rmskkn/fanny/hardware/datasheets/README.md

# Datasheets

The PDFs are not stored in the repository. Download them from the manufacturers:

| Part | Source |
|---|---|
| STM32F103C8T6 | https://www.st.com/en/microcontrollers-microprocessors/stm32f103c8.html (datasheet DS5319, reference manual RM0008) |
| BSS138 | https://www.onsemi.com/products/discrete-power-modules/mosfets/bss138 |
| BAT54S | https://www.nexperia.com/products/diodes/schottky-diodes-and-rectifiers |
| SMBJ13A | https://www.littelfuse.com (SMBJ series) |
| AO3401A | https://www.aosmd.com (AO3401A, `Q_hs` high-side P-MOSFET) |
| MMBT3906 | https://www.onsemi.com/products/discrete-power-modules/bipolar-transistors/mmbt3906 (`Q_pnp` level shifter) |
| SS34 | https://www.diodes.com (SS3x Schottky series, fan motor flyback diode) |
| MF-MSMF250/16X / MF-MSMF110/16 | https://www.bourns.com (MF-MSMF series) |
| NTC 10 kΩ B3950 | Probe bundled with the [Skip0ner 1X4L fan-1248 conf v1](https://skiponer.com/1x4l-pwm-fan-controller-manual/) module (AIN NTC; no separate manufacturer PDF, see `hardware/datasheets/NTC-10k-B3950 Response Curve.md`) |
| 4-wire fan spec | Intel "4-Wire Pulse Width Modulation (PWM) Controlled Fans" rev 1.3 |
