rmskkn/fanny/hardware/pcb_top.png

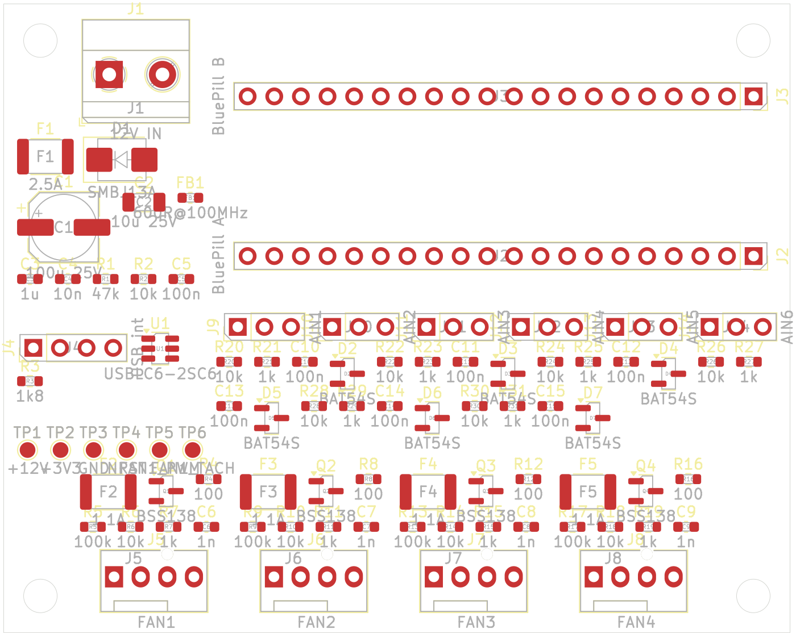
hardware/pcb_top.png
