rmskkn/fanny/hardware/bom.csv

Qty | References | Value | Footprint | MPN (example) | DigiKey PN | DigiKey URL | Notes | DNP
1 | C1 | 100n | C_0603_1608Metric | Yageo CC0603KRX7R9BB104 | 311-1344-2-ND | https://www.digikey.com/en/products/detail/yageo/CC0603KRX7R9BB104/2103082
4 | C2 C3 C4 C5 | 1n | C_0603_1608Metric | Yageo CC0603KRX7R9BB102 | 311-1080-2-ND | https://www.digikey.com/en/products/detail/yageo/CC0603KRX7R9BB102/302814
1 | D1 | SMBJ13A | D_SMB | Littelfuse SMBJ13A | SMBJ13ALFTR-ND | https://www.digikey.com/en/products/detail/littelfuse-inc/SMBJ13A/285974
4 | D2 D3 D4 D5 | SS34 | D_SMA | SMC Diode Solutions SS34AF | 1655-SS34AFTR-ND | https://www.digikey.com/en/products/detail/smc-diode-solutions/SS34AF/21705400
4 | D6 D7 D8 D9 | BAT54S | SOT-23 | Nexperia BAT54S,215 | 1727-2904-2-ND | https://www.digikey.com/en/products/detail/nexperia-usa-inc/BAT54S-215/763218
1 | F1 | 2.5A | Fuse_1812_4532Metric | Bourns MF-MSMF250/16X-2 | MF-MSMF250/16X-2TR-ND | https://www.digikey.com/en/products/detail/bourns-inc/MF-MSMF250-16X-2/2563289
4 | F2 F3 F4 F5 | 1.1A | Fuse_1812_4532Metric | Bourns MF-MSMF110/16-2 | MF-MSMF110/16-2TR-ND | https://www.digikey.com/en/products/detail/bourns-inc/MF-MSMF110-16-2/662820 | Bourns marks this Not For New Designs (in stock, fine for prototype)
1 | J1 | 12V IN | ConnHeader_MateNLok_1x04_P5.08mm_Vertical | On-Shore Technology OSTOQ045450 | ED2845-ND | https://www.digikey.com/en/products/detail/on-shore-technology-inc/OSTOQ045450/1588257
1 | J2 | BluePill A | PinSocket_1x20_P2.54mm_Vertical | Sullins PPTC201LFBN-RC | S7018-ND | https://www.digikey.com/en/products/detail/sullins-connector-solutions/PPTC201LFBN-RC/810158
1 | J3 | BluePill B | PinSocket_1x20_P2.54mm_Vertical | Sullins PPTC201LFBN-RC | S7018-ND | https://www.digikey.com/en/products/detail/sullins-connector-solutions/PPTC201LFBN-RC/810158
1 | J4 | FAN1 | FanPinHeader_1x04_P2.54mm_Vertical | Molex 47053-1000 | WM4330-ND | https://www.digikey.com/en/products/detail/molex/0470531000/2421261
1 | J5 | FAN2 | FanPinHeader_1x04_P2.54mm_Vertical | Molex 47053-1000 | WM4330-ND | https://www.digikey.com/en/products/detail/molex/0470531000/2421261
1 | J6 | FAN3 | FanPinHeader_1x04_P2.54mm_Vertical | Molex 47053-1000 | WM4330-ND | https://www.digikey.com/en/products/detail/molex/0470531000/2421261
1 | J7 | FAN4 | FanPinHeader_1x04_P2.54mm_Vertical | Molex 47053-1000 | WM4330-ND | https://www.digikey.com/en/products/detail/molex/0470531000/2421261
1 | J8 | AIN3 | PinHeader_1x03_P2.54mm_Vertical | Sullins PRPC003SAAN-RC | 35-PRPC003SAAN-RC-ND | https://www.digikey.com/en/products/detail/sullins-connector-solutions/PRPC003SAAN-RC/2775251
1 | J9 | AIN4 | PinHeader_1x03_P2.54mm_Vertical | Sullins PRPC003SAAN-RC | 35-PRPC003SAAN-RC-ND | https://www.digikey.com/en/products/detail/sullins-connector-solutions/PRPC003SAAN-RC/2775251
1 | J10 | AIN1 | PinHeader_1x03_P2.54mm_Vertical | Sullins PRPC003SAAN-RC | 35-PRPC003SAAN-RC-ND | https://www.digikey.com/en/products/detail/sullins-connector-solutions/PRPC003SAAN-RC/2775251
1 | J11 | AIN2 | PinHeader_1x03_P2.54mm_Vertical | Sullins PRPC003SAAN-RC | 35-PRPC003SAAN-RC-ND | https://www.digikey.com/en/products/detail/sullins-connector-solutions/PRPC003SAAN-RC/2775251
8 | Q1 Q2 Q5 Q6 Q11 Q12 Q17 Q18 | AO3401A | SOT-23 | Alpha & Omega AO3401A | 785-1001-2-ND | https://www.digikey.com/en/products/detail/alpha-omega-semiconductor-inc/AO3401A/1855773 | Not MMBT3906 - that part is no longer used
12 | Q3 Q4 Q7 Q8 Q9 Q10 Q13 Q14 Q15 Q16 Q19 Q20 | BSS138 | SOT-23 | MCC BSS138-TP | BSS138-TPMSTR-ND | https://www.digikey.com/en/products/detail/mcc-micro-commercial-components/BSS138-TP/10054628
13 | R1 R6 R7 R8 R14 R15 R19 R23 R24 R28 R32 R35 R37 | 10k | R_0603_1608Metric | Vishay Dale CRCW060310K0FKEA | 541-10.0KHTR-ND | https://www.digikey.com/en/products/detail/vishay-dale/CRCW060310K0FKEA/1174782
1 | R2 | 3.3k | R_0603_1608Metric | Vishay Dale CRCW06033K30FKEA | 541-3.30KHTR-ND | https://www.digikey.com/en/products/detail/vishay-dale/CRCW06033K30FKEA/1174725
4 | R3 R12 R21 R38 | 4.7k | R_0603_1608Metric | Yageo RC0603FR-074K7L | 311-4.70KHRTR-ND | https://www.digikey.com/en/products/detail/yageo/RC0603FR-074K7L/727212
8 | R4 R10 R13 R17 R25 R26 R31 R33 | 100 | R_0603_1608Metric | Vishay Dale CRCW0603100RFKEA | 541-100HTR-ND | https://www.digikey.com/en/products/detail/vishay-dale/CRCW0603100RFKEA/1174554
4 | R5 R16 R22 R30 | 2.2k | R_0603_1608Metric | Yageo RC0603FR-072K2L | 311-2.20KHRTR-ND | https://www.digikey.com/en/products/detail/yageo/RC0603FR-072K2L/727016
8 | R9 R20 R29 R36 R43 R44 R45 R46 | 1k | R_0603_1608Metric | Vishay Dale CRCW06031K00FKEA | 541-1.00KHTR-ND | https://www.digikey.com/en/products/detail/vishay-dale/CRCW06031K00FKEA/1174668
4 | R11 R18 R27 R34 | 100k | R_0603_1608Metric | Vishay Dale CRCW0603100KFKEA | 541-100KHTR-ND | https://www.digikey.com/en/products/detail/vishay-dale/CRCW0603100KFKEA/1174896
4 | R39 R40 R41 R42 | 33k | R_0603_1608Metric | Vishay Dale CRCW060333K0FKEA | 541-33.0KHTR-ND | https://www.digikey.com/en/products/detail/vishay-dale/CRCW060333K0FKEA/1174839
