rmskkn/fanny/hardware/kicad/fan_controller.step

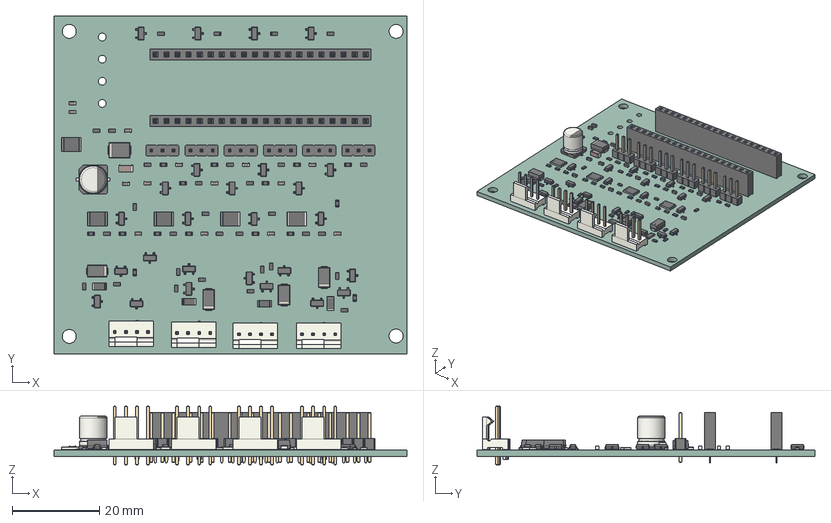
[picture p3: CAD file, 2026-10-23]
hardware/kicad/fan_controller.step
81.0 x 77.5 x 13.5 mm
R_0603_1608Metric x 46
C_0603_1608Metric x 13
R_1206_3216Metric x 4
R_1812_4532Metric x 5
SOT-23 x 16
CP_Elec_63x77
PinHeader_1x03_P254mm_Vertical x 6
SOT_23 x 10
PinSocket_1x20_P2.54mm_Vertical x 2
Fan_Pin_Header_Straight_1x04 x 4
D_SMA x 4
L_0603_1608Metric
C_1206_3216Metric
D_SMB
fan_controller_PCB
