rmskkn/fanny/hardware/kicad/fan_controller.kicad_pcb

## KiCad design hardware/kicad/fan_controller.kicad_pcb (2026-11-14)

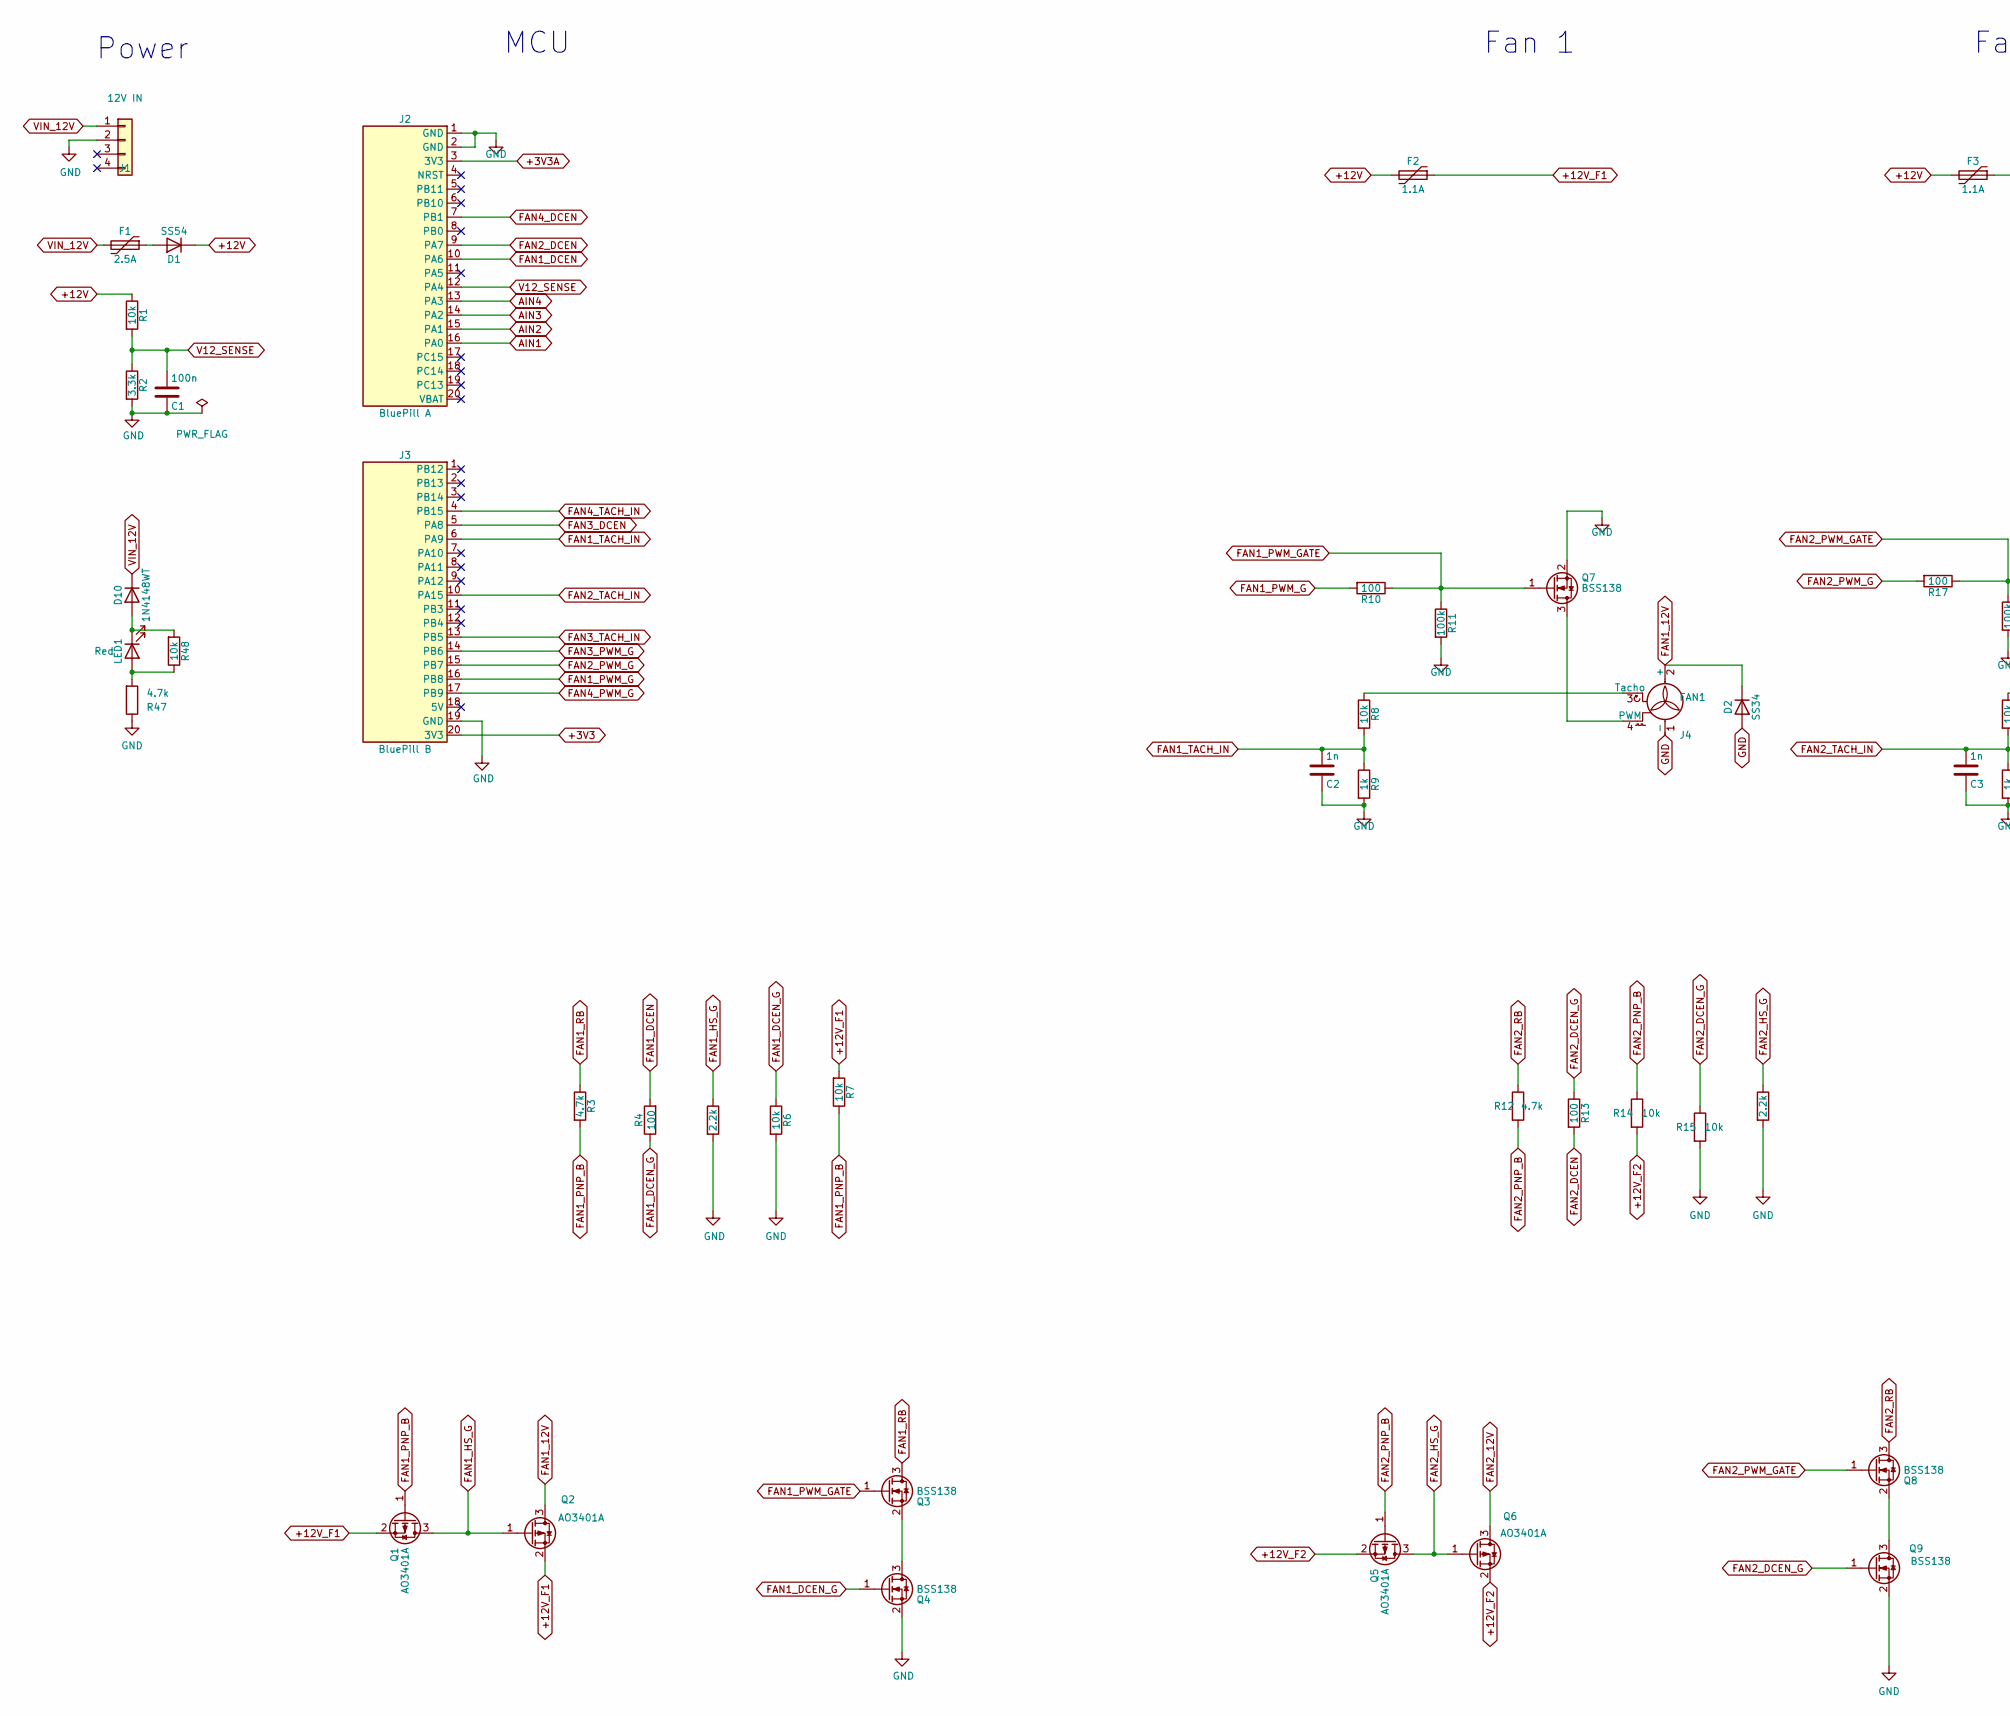
[picture p4: schematic fan_controller.kicad_sch, Fanny - versatile USB PWM fan controller, part in row 1, column 1]

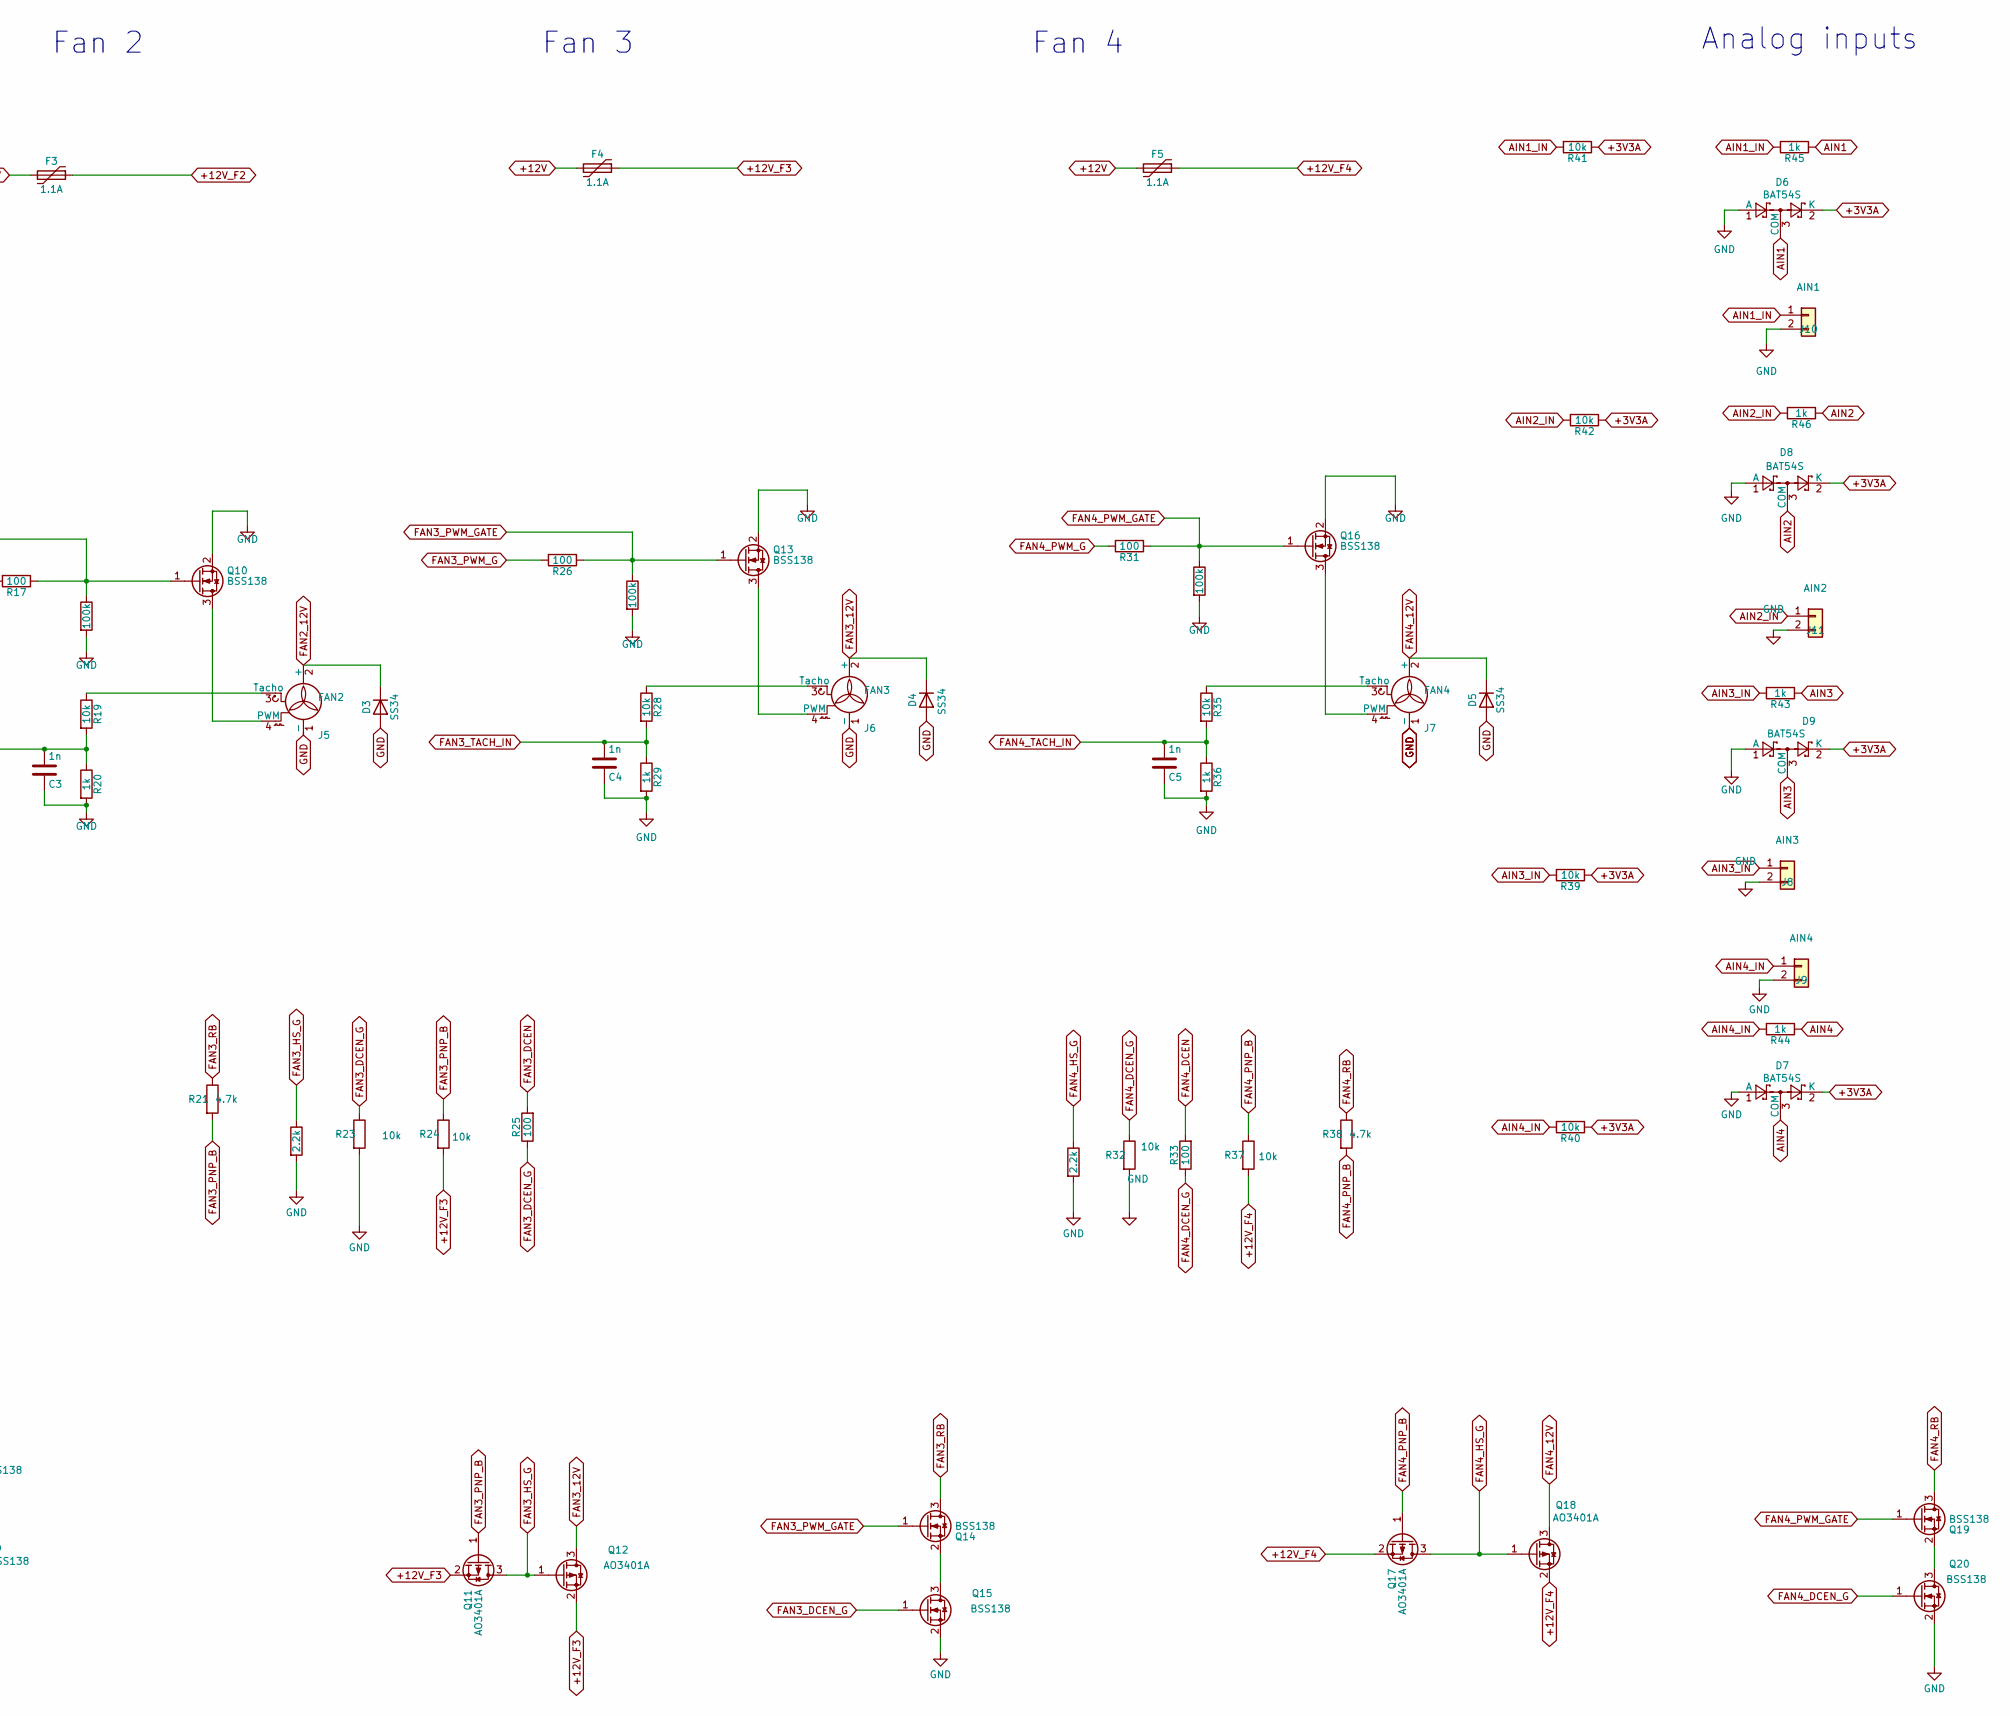
[picture p5: schematic fan_controller.kicad_sch, Fanny - versatile USB PWM fan controller, part in row 1, column 2]

Parts:
C1: 100n; C_0603_1608Metric
C2, C3, C4, C5: 1n; C_0603_1608Metric
D1: SS54; D_SMB; MPN Littelfuse SMBJ13A
D2, D3, D4, D5: SS34; D_SMA; MPN SS34
D6, D7, D8, D9: BAT54S; SOT-23; MPN Nexperia BAT54S,215
D10: 1N4148WT; D_SOD-523
F1: 2.5A; Fuse_1812_4532Metric; MPN Bourns MF-MSMF250/16X-2
F2, F3, F4, F5: 1.1A; Fuse_1812_4532Metric; MPN Bourns MF-MSMF110/16-2
J1: 12V IN; ConnHeader_MateNLok_1x04_P5.08mm_Vertical; MPN TE Connectivity 350424-1
J2: BluePill A; PinSocket_1x20_P2.54mm_Vertical
J3: BluePill B; PinSocket_1x20_P2.54mm_Vertical
J4: FAN1; FanPinHeader_1x04_P2.54mm_Vertical; MPN Molex 47053-1000
J5: FAN2; FanPinHeader_1x04_P2.54mm_Vertical; MPN Molex 47053-1000
J6: FAN3; FanPinHeader_1x04_P2.54mm_Vertical; MPN Molex 47053-1000
J7: FAN4; FanPinHeader_1x04_P2.54mm_Vertical; MPN Molex 47053-1000
J8: AIN3; JST_PH_B2B-PH-K_1x02_P2.00mm_Vertical
J9: AIN4; JST_PH_B2B-PH-K_1x02_P2.00mm_Vertical
J10: AIN1; JST_PH_B2B-PH-K_1x02_P2.00mm_Vertical
J11: AIN2; JST_PH_B2B-PH-K_1x02_P2.00mm_Vertical
LED1: Red; LED_0603_1608Metric
Q1, Q2, Q5, Q6, Q11, Q12, Q17, Q18: AO3401A; SOT-23; MPN Alpha & Omega AO3401A
Q3, Q7, Q8, Q10, Q13, Q14, Q16, Q19: BSS138; SOT-23; MPN onsemi BSS138
Q4, Q9, Q15, Q20: BSS138; SOT-23
R1, R6, R7, R8, R14, R15, R19, R23, R24, R28, R32, R35, R37, R39, R40, R41, R42, R48: 10k; R_0603_1608Metric
R2: 3.3k; R_0603_1608Metric
R3, R12, R21, R38: 4.7k; R_0603_1608Metric
R4, R10, R13, R17, R25, R26, R31, R33: 100; R_0603_1608Metric
R5, R16, R22, R30: 2.2k; R_0603_1608Metric
R9, R20, R29, R36, R43, R44, R45, R46: 1k; R_0603_1608Metric
R11, R18, R27, R34: 100k; R_0603_1608Metric
R47: 4.7k; R_1206_3216Metric

Connections:
+3V3: J3.20 (3V3); also elsewhere on the board
+3V3A: D6.2 (K), D7.2 (K), D8.2 (K), D9.2 (K), J2.3 (3V3), R39.1, R40.1, R41.1, R42.1; also elsewhere on the board
+12V: D1.1 (K), F2.2, F3.2, F4.2, F5.2, R1.1
+12V_F1: F2.1, Q1.2 (S), Q2.2 (S), R7.2
+12V_F2: F3.1, Q5.2 (S), Q6.2 (S), R14.2
+12V_F3: F4.1, Q11.2 (S), Q12.2 (S), R24.2
+12V_F4: F5.1, Q17.2 (S), Q18.2 (S), R37.2
AIN1: D6.3 (COM), J2.16 (PA0), R45.1
AIN1_IN: J10.1, R41.2, R45.2
AIN2: D8.3 (COM), J2.15 (PA1), R46.1
AIN2_IN: J11.1, R42.2, R46.2
AIN3: D9.3 (COM), J2.14 (PA2), R43.1
AIN3_IN: J8.1, R39.2, R43.2
AIN4: D7.3 (COM), J2.13 (PA3), R44.1
AIN4_IN: J9.1, R40.2, R44.2
FAN1_12V: D2.1 (K), J4.2 (+), Q2.3 (D)
FAN1_DCEN: J2.10 (PA6), R4.2
FAN1_DCEN_G: Q4.1 (G), R4.1, R6.1
FAN1_HS_G: Q1.3 (D), Q2.1 (G), R5.1
FAN1_PNP_B: Q1.1 (G), R3.2, R7.1
FAN1_PWM_G: J3.16 (PB8), R10.2
FAN1_PWM_GATE: Q3.1 (G), Q7.1 (G), R10.1, R11.1
FAN1_RB: Q3.3 (D), R3.1
FAN1_TACH_IN: C2.1, J3.6 (PA9), R8.2, R9.1; also elsewhere on the board
FAN2_12V: D3.1 (K), J5.2 (+), Q6.3 (D)
FAN2_DCEN: J2.9 (PA7), R13.2
FAN2_DCEN_G: Q9.1 (G), R13.1, R15.1
FAN2_HS_G: Q5.3 (D), Q6.1 (G), R16.1
FAN2_PNP_B: Q5.1 (G), R12.2, R14.1
FAN2_PWM_G: J3.15 (PB7), R17.2
FAN2_PWM_GATE: Q8.1 (G), Q10.1 (G), R17.1, R18.1
FAN2_RB: Q8.3 (D), R12.1
FAN2_TACH_IN: C3.1, J3.10 (PA15), R19.2, R20.1; also elsewhere on the board
FAN3_12V: D4.1 (K), J6.2 (+), Q12.3 (D)
FAN3_DCEN: J3.5 (PA8), R25.2
FAN3_DCEN_G: Q15.1 (G), R23.1, R25.1
FAN3_HS_G: Q11.3 (D), Q12.1 (G), R22.1
FAN3_PNP_B: Q11.1 (G), R21.2, R24.1
FAN3_PWM_G: J3.14 (PB6), R26.2
FAN3_PWM_GATE: Q13.1 (G), Q14.1 (G), R26.1, R27.1
FAN3_RB: Q14.3 (D), R21.1
FAN3_TACH_IN: C4.1, J3.13 (PB5), R28.2, R29.1; also elsewhere on the board
FAN4_12V: D5.1 (K), J7.2 (+), Q18.3 (D)
FAN4_DCEN: J2.7 (PB1), R33.2
FAN4_DCEN_G: Q20.1 (G), R32.1, R33.1
FAN4_HS_G: Q17.3 (D), Q18.1 (G), R30.1
FAN4_PNP_B: Q17.1 (G), R37.1, R38.2
FAN4_PWM_G: J3.17 (PB9), R31.2
FAN4_PWM_GATE: Q16.1 (G), Q19.1 (G), R31.1, R34.1
FAN4_RB: Q19.3 (D), R38.1
FAN4_TACH_IN: C5.1, J3.4 (PB15), R35.2, R36.1; also elsewhere on the board
GND: C1.2, C2.2, C3.2, C4.2, C5.2, D2.2 (A), D3.2 (A), D4.2 (A), D5.2 (A), D6.1 (A), D7.1 (A), D8.1 (A), D9.1 (A), J1.2, J2.1 (GND), J2.2 (GND), J3.19 (GND), J4.1 (-), J5.1 (-), J6.1 (-), J7.1 (-), J8.2, J9.2, J10.2, J11.2, Q4.2 (S), Q7.2 (S), Q9.2 (S), Q10.2 (S), Q13.2 (S), Q15.2 (S), Q16.2 (S), Q20.2 (S), R2.2, R5.2, R6.2, R9.2, R11.2, R15.2, R16.2, R18.2, R20.2, R22.2, R23.2, R27.2, R29.2, R30.2, R32.2, R34.2, R36.2, R47.1; also elsewhere on the board
unnamed: D1.2 (A), F1.1
unnamed: D10.2 (A), LED1.1 (K), R48.2
unnamed: J4.4 (PWM), Q7.3 (D)
unnamed: J4.3 (Tacho), R8.1
unnamed: J5.4 (PWM), Q10.3 (D)
unnamed: J5.3 (Tacho), R19.1
unnamed: J6.4 (PWM), Q13.3 (D)
unnamed: J6.3 (Tacho), R28.1
unnamed: J7.4 (PWM), Q16.3 (D)
unnamed: J7.3 (Tacho), R35.1
unnamed: LED1.2 (A), R47.2, R48.1
unnamed: Q3.2 (S), Q4.3 (D)
unnamed: Q8.2 (S), Q9.3 (D)
unnamed: Q14.2 (S), Q15.3 (D)
unnamed: Q19.2 (S), Q20.3 (D)
V12_SENSE: C1.1, J2.12 (PA4), R1.2, R2.1
VIN_12V: D10.1 (K), F1.2, J1.1

Notes on the sheet:
Analog inputs
Power
Fan 3
MCU
Fan 2
Fan 1
Fan 4

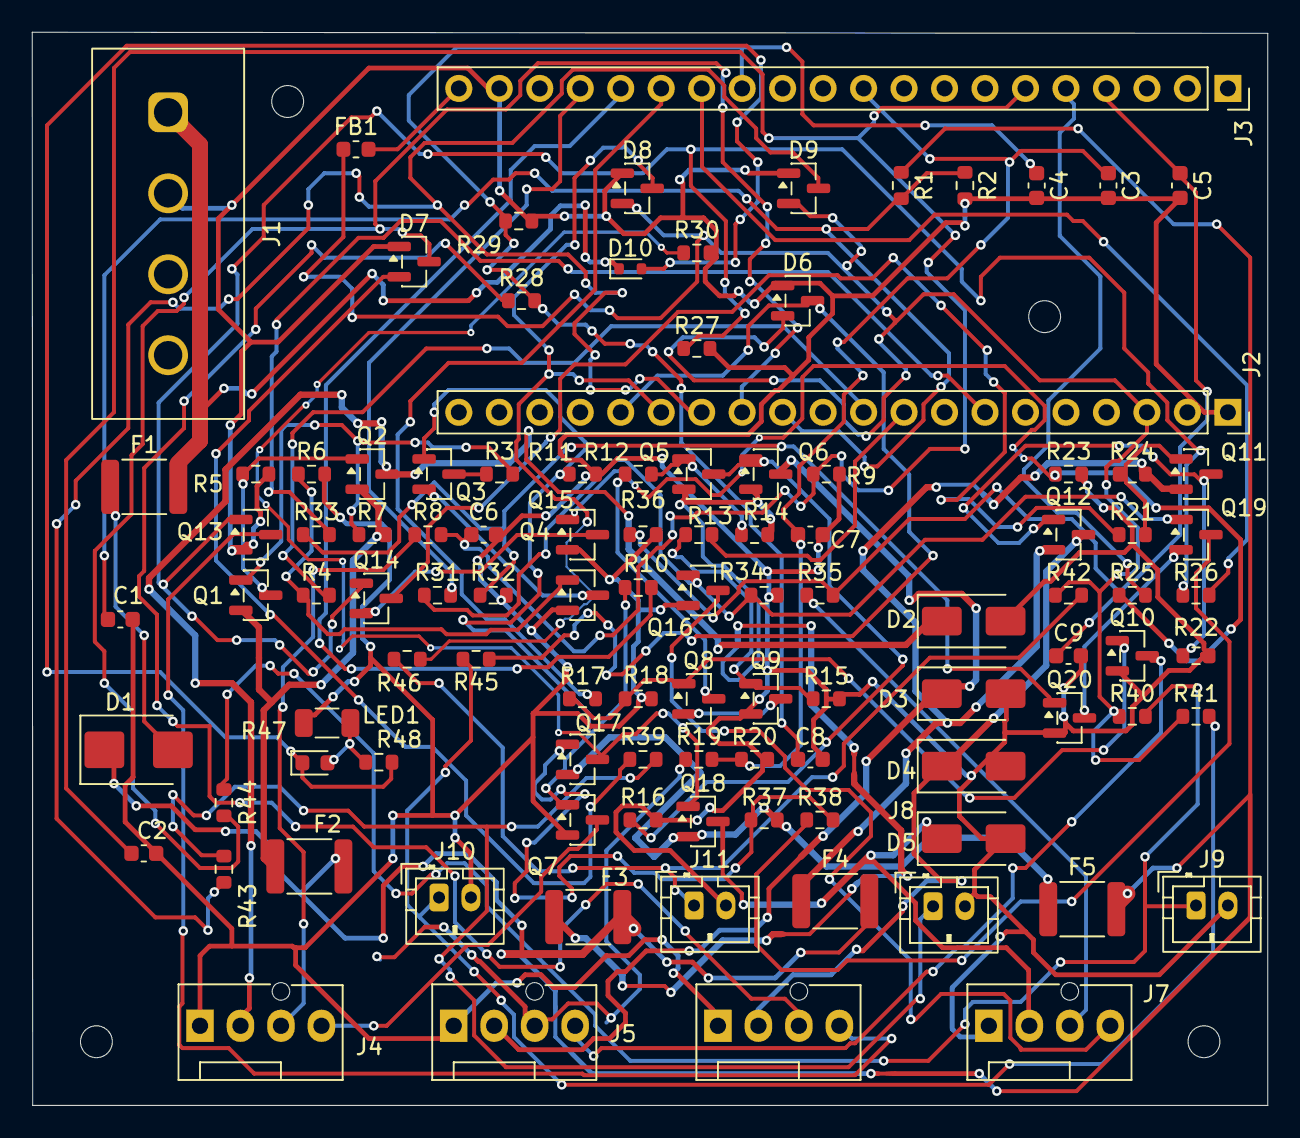
[picture p6: board fan_controller.kicad_pcb from above]

Board: 2 copper layers, 77.5 x 67.3 mm, 109 parts (0 on the bottom side), 69 nets.

Other parts of the board:
C6, C7, C8, C9: 1n; C_0603_1608Metric
FB1: 600R@100MHz; L_0603_1608Metric
MH1, MH2, MH3, MH4: MountingHole_2mm

Their connections:
+3V3: FB1.2; also elsewhere on the board
+3V3A: FB1.1; also elsewhere on the board
FAN1_TACH_IN: C6.1; also elsewhere on the board
FAN2_TACH_IN: C7.1; also elsewhere on the board
FAN3_TACH_IN: C8.1; also elsewhere on the board
FAN4_TACH_IN: C9.1; also elsewhere on the board
GND: C6.2, C7.2, C8.2, C9.2; also elsewhere on the board
