rmskkn/fanny/(commit log)

2026-10-20 Add STM32F103 USB PWM fan controller
    Hardware: KiCad 8 project generated by hardware/tools/gen_kicad.py,
    with BOM. Four 12 V fan channels use an IRLML6402 high-side switch
    with gate protection (4.7k/4.7k divider, 10 V zener clamp), a BSS138
    open-drain buffer for the 25 kHz PWM line and a filtered tach input.
    Six analog inputs have NTC bias, RC filter and BAT54S clamps.
    ERC is clean in KiCad 8.0.9.
    Firmware: libopencm3 (git submodule) USB CDC device with a text
    protocol, per-channel pwm/dc modes, tach RPM, ADC by DMA, watchdog,
    host-loss failsafe and stall detection. Host-side protocol tests run
    with `make test`.
    Host: fanctl.py pyserial client.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
    [bom.csv, fan_controller.kicad_pcb, fan_controller.kicad_sch]
2026-10-20 docs: explain setting a single fan channel
2026-10-21 hw: replace discontinued P-FET, protect LDO, fuse each fan
    - AO3401A (-30 V) replaces the discontinued IRLML6402. The 30 V rating
    also covers the SMBJ13A's 21.5 V clamp.
    - 47 R feed and 13 V zener hold the AMS1117 input below its 15 V limit
    during rail surges.
    - Tantalum output capacitor for AMS1117 stability.
    - 1.1 A PTC per fan channel, so one shorted fan does not trip F1.
    - Six test pads: +12V, +3V3, GND, NRST, FAN1_PWM, FAN1_TACH.
    [bom.csv, fan_controller.kicad_sch]
2026-10-21 docs: add DigiKey links to BOM summary
    Each part links to a DigiKey keyword search for its MPN, so the links
    keep working when DigiKey part numbers change.
2026-10-21 hw: Blue Pill carrier, first placement and 3D model
    The board is now a carrier for an STM32F103C8T6 Blue Pill module in two
    1x20 sockets. The module brings the MCU, crystal, 3.3 V regulator, LED,
    reset, BOOT jumpers, SWD and micro-B USB, so those parts are removed.
    An AMS1117-5.0 feeds the module's 5V pin through an SS14, which stops
    USB VBUS from back-feeding the regulator. R4 (DNP) corrects modules
    whose D+ pull-up is 10k. Header pinout follows the DeepBlueMbedded
    Blue Pill diagram.
    place_pcb.py places every footprint by block (placed, not routed),
    checks overlaps, board edges and mounting holes, and exports
    fan_controller.step and .glb. The STEP models are committed under
    hardware/kicad/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
    [bom.csv, fan_controller.kicad_pcb, fan_controller.kicad_sch, fan_controller.step]
2026-10-21 docs: show 3D render of the board at the top of README
    The previous top image was the 2D placement plot. pcb_3d.png is rendered
    with kicad-cli pcb render from KiCad 9, since KiCad 8's CLI cannot
    render. The placement plot moves to the KiCad project section.
2026-10-21 hw: power Blue Pill from USB, feed fans straight from 12 V
    The Blue Pill now runs from USB only, so the AMS1117-5.0 and its
    protection (47 R, 13 V zener, tantalum, SS14 OR diode) are removed.
    Fan pin 2 connects to +12 V through its 1.1 A PTC. The high-side
    P-FET, its gate network, level shifter and freewheel diode are gone
    from every channel. Fans now run at 100 % whenever the module is
    unpowered, held in reset or missing, because the PWM buffer releases
    the line. Before, unplugging USB would have switched every fan off.
    3-pin fans and the hard stop at 0 % are no longer supported.
    Firmware 2.0 drops TIM2 and the mode command; get no longer prints
    mode=. fanctl.py drops its mode subcommand.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
    [bom.csv, fan_controller.kicad_pcb, fan_controller.kicad_sch, fan_controller.step]
2026-10-21 hw: resave project in KiCad 10 file format
    [fan_controller.kicad_pcb, fan_controller.kicad_sch]
2026-10-21 build: ignore KiCad lock files, local history, DRC export
2026-10-21 hw: remove dangling stub vias and traces from routing cleanup
    20 vias left connected on only one copper layer, plus the short
    track stubs feeding them, after an earlier routing edit. DRC now
    reports 0 errors (was 0 before too) and 0 dangling-via/track
    warnings; all affected nets remain fully connected.
    [fan_controller.kicad_pcb]
2026-10-21 hw: route 21 missing nets, remove 3V3/GND test point pair
    21 nets (mostly BluePill header J2/J3 to main-board parts) were
    never actually routed, despite earlier DRC checks reporting zero
    errors - the MCP DRC wrapper used doesn't run KiCad's unconnected-
    items check. Verified with native kicad-cli --severity-all.
    Routed via Freerouting (autoroute, best-of-3), then manually closed
    the 2 nets it couldn't finish (GND, +3V3A) and fixed a short the
    autorouted +3V3A trace made against an existing GND track, plus a
    board-edge clearance violation on FAN3_TACH.
    Also removed TP2 (+3V3) / TP3 (GND), a probe pair that served no
    circuit function, plus their stub traces.
    Native kicad-cli DRC (10.0.7): 0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
    [fan_controller.kicad_pcb, fan_controller.kicad_sch]
2026-10-21 hw: swap 12V connector to Mate-N-Lok, drop main-board USB, rotate J3
    Replace J1 (2-pin Phoenix screw terminal) with TE Connectivity
    350424-1, a 4-circuit Mate-N-Lok PCB header (2x GND + 2x VIN_12V,
    12A/250V per pin, 0.2in pitch). Custom footprint built from the
    part's real datasheet drawing (drill/pitch), registered as a
    project-local fanctl.pretty library since no footprint libraries
    are installed in this environment.
    Remove the main-board USB path entirely (J4 header, U1 ESD chip,
    R3 pullup): the Blue Pill module's own USB port covers this, so
    routing USB_DP/USB_DM across the main board was unnecessary. This
    also freed board area.
    Rotate J3 (Blue Pill B header) 180 degrees in place, and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
    [fan_controller.kicad_pcb, fan_controller.kicad_sch]
2026-10-21 hw: clear DRC/ERC library and dangling-net warnings
    Remove 4 dangling track stubs and 6 vestigial single-layer vias left
    over from prior routing cleanup. Sync J1 (Mate-N-Lok) footprint
    against its fanctl library copy by adding the missing attr/
    remove_unused_layers flags, clearing the lib_footprint_mismatch
    warning. Resync 68 standard-part footprints (R/C/L/Fuse/SOT-23/
    PinHeader/PinSocket) against the now-installed KiCad system
    libraries: swap stale multi-segment silk/fab/courtyard graphics for
    the current library primitives, and fix oval-vs-circle pad shape
    drift on PinHeader_1x03/PinSocket_1x20 (same pad size, cosmetic only).
    DRC: 0 errors, 149 -> 66 warnings (remaining are silk_overlap/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
    [fan_controller.kicad_pcb]
2026-10-21 hw: hide crowded reference-designator silkscreen to clear DRC warnings
    Root cause of nearly all silk_overlap/silk_over_copper DRC warnings:
    default 0603/SOT-23/Fuse reference-text offset lands on copper or a
    neighbor's silkscreen in the tightly packed per-channel rows. Hide
    (F.SilkS visible=false) the reference text on the 21 footprints
    where it is the exact or near-exact source (C2, C10, F1, Q1, R5-R7,
    R9-R11, R13-R14, R17-R19, R22-R23, R26, R29, R31, TP4); labels remain
    in the BOM/pos file and F.Fab layer, just not printed on crowded
    silk.
    DRC: 66 -> 19 warnings, all silk_overlap. Remainder is SOT-23 (D2-D4)
    body outline physically crowding neighboring 0603 pads/silk in the
    same tight row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
    [fan_controller.kicad_pcb]
2026-10-21 hw: hide remaining crowded reference silkscreen (D2-D4, R22, R25, Q2)
    Same root cause as the previous pass: default reference-text offset
    on the AIN-row BAT54S diodes (D2-D4) and their adjacent 10k resistors
    (R22, R25), plus FAN2's Q2, lands on a neighbor's silk in the tightly
    packed per-channel layout. Hide (F.SilkS visible=false) those six;
    labels remain in BOM/pos and F.Fab.
    DRC: 19 -> 14 warnings, still silk_overlap only, 0 errors.
    Remaining 14 are body-outline-vs-body-outline collisions between
    correctly library-matched parts (PinHeader_1x03 J10-J14 vs adjacent
    BAT54S/SOT-23 pin-1 marks, and Q2 vs R11): neither side's graphics
    can be trimmed without reopening lib_footprint_mismatch, s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
    [fan_controller.kicad_pcb]
2026-10-21 hw: regenerate and shrink 3D render for GitHub
    Re-render pcb_3d.png against the current board state (post DRC
    cleanup) and shrink it to 448x480 so it's reasonable to embed in the
    GitHub README: 1904x1432/712KB -> 448x480/139KB.
2026-10-21 hw: switch 3D render to angled side view
    Replace the flat top-down render with a perspective angle
    (rotate -60,0,25) showing board depth and connector height instead
    of a flat silk view. Same 448x480 footprint, 139KB -> 163KB.
2026-10-22 hw: rotate render 180deg and use transparent background
    Rotate z-axis to 350deg (net +180 from the previous 170deg), keep
    zoom 0.75 so the full board stays in frame, and switch to
    --background transparent so the PNG composites cleanly over any
    page background instead of carrying opaque white.
2026-10-22 docs: actualize README for Mate-N-Lok J1 and no carrier USB
    Remove the carrier-board USB header/ESD/pull-up (J4, U1, R3) from the
    docs -- USB is now the Blue Pill's micro-B connector only. Fix the J1
    BOM/diagram entries to the Mate-N-Lok 350424-1 connector, bump KiCad
    8 references to 10 (Docker images, 3D model path variable, render
    command), and refresh the DRC/ERC check results to current numbers.
    Flag that gen_kicad.py/bom.csv are stale (still emit the removed USB
    parts and the old 2-pin terminal J1) so nobody reruns them blind.
2026-10-22 hw: sync schematic to board after removing TP1/TP4 test points
    Board no longer carries TP1 (+12V probe) and TP4 (NRST probe); remove
    the matching symbols and their orphaned net labels from the schematic
    so both files agree. Cross-checked all 77 references: footprints and
    values now match exactly between schematic and board.
    ERC: 0 errors, 4 warnings (pre-existing single-pin-label style,
    consistent with the rest of the sheet).
    [fan_controller.kicad_pcb, fan_controller.kicad_sch]
2026-10-22 hw: regenerate pcb_3d.png at current board state, high quality
    Render directly at 480x500 with --quality high (the highest fixed
    tier) -- picks up the current board (TP1/TP4 removed) and keeps the
    render command and file size simple.
    Add SESSION_SUMMARY.md, tracking this session's KiCad MCP/kicad-cli
    work: DRC/ERC cleanup history, full silk-violation root causes and
    fixes, the pcb_3d.png render command, and tool choices.
2026-10-22 docs: drop stale gen_kicad.py gap note and pcb_top.png embed
    The schematic now matches the board (4d1f643), so the gen_kicad.py/
    bom.csv staleness warning about J1 and USB no longer needs calling
    out as a blocking caveat. Drop the pcb_top.png image embed too.
2026-10-22 hw: sync schematic to board after removing TP5/TP6, regen render
    Board no longer carries TP5 (FAN1_PWM probe) and TP6 (FAN1_TACH
    probe); remove the matching symbols and their orphaned net labels
    from the schematic so both files agree. Cross-checked all 75
    references: footprints match exactly between schematic and board.
    ERC: 0 errors, 4 warnings (pre-existing single-pin-label style).
    Regenerated hardware/pcb_3d.png at current board state.
    [fan_controller.kicad_pcb, fan_controller.kicad_sch]
2026-10-22 docs: relicense project under CC BY-NC-SA 4.0
    Replace GPL-3.0 with CC BY-NC-SA 4.0 (canonical legal code from
    creativecommons.org) so personal and other non-commercial use stays
    free while commercial resale of boards, bare PCBs, or kits needs a
    separate written license.
    Add a License section to README naming the copyright holder, the
    permitted non-commercial scope, and the libopencm3 submodule as
    separately licensed under LGPL-3.0.
    Relicensing is clean: all 24 commits are by the sole author and no
    GPL-3.0 version was ever pushed to a remote.
2026-10-22 hw: export gerber and drill files for PCBWay fab
    [fan_controller-B_Cu.gbl, fan_controller-B_Mask.gbs, fan_controller-B_Paste.gbp, fan_controller-B_Silkscreen.gbo, fan_controller-Edge_Cuts.gm1, fan_controller-F_Cu.gtl, fan_controller-F_Mask.gts, fan_controller-F_Paste.gtp]
2026-10-22 docs: add Intel 4-wire fan compatibility table and TODO section
2026-10-22 host: add systemd fan control daemon with per-channel temp curves
    fancontrold.py reads an INI config (constant duty, or a temperature
    curve against an AIN/NTC channel) and pings the board every cycle to
    hold off the firmware's 10 s failsafe. Ships a systemd user unit and
    an example config.
    [fancontrold.py]
2026-10-22 fw: fix FAN1/FAN3 PWM channel swap from hand-edited PCB
    PCB pads show TIM4_CH1 (PB6) wired to the FAN3 header and TIM4_CH3
    (PB8) wired to the FAN1 header, crossed from the schematic's nominal
    assignment. Remap pwm.c's channel table to match the actual copper.
    [board.h, pwm.c]
2026-10-22 host: add nvidia-smi GPU temperature curve to fancontrold
    New GpuCurveChannel (sensor = gpuN) drives a fan from an NVIDIA GPU's
    temperature, taking the max of core and memory temp the way
    github.com/rmskkn/v100-fan-control queries nvidia-smi. Reuses the
    existing curve interpolation and daemon ping loop; no new dependency,
    no new systemd unit.
2026-10-22 rename project to Fanny, drop gen_kicad.py/place_pcb.py generator scripts
    Title: "Fanny - a versatile USB PWM fan controller" (README, schematic
    and PCB title blocks).
    KiCad files are now hand-maintained directly and are the source of
    truth; place_pcb.py depended on gen_kicad.py's PARTS table and had no
    purpose without it. Updated README's KiCad project section, folder
    tree, and 3dmodels/README.md accordingly, and the schematic's stale
    "generated by" comment.
    [fan_controller.kicad_pcb, fan_controller.kicad_sch]
2026-10-23 hw: fix AIN4/AIN5 short and split GND net on PCB
    Resolve every DRC error on fan_controller.kicad_pcb. Only the 14
    silk_overlap warnings remain, and those are cosmetic.
    AIN4 was routed to the wrong Blue Pill pin. Its F.Cu track ended on
    J2 pad 13 (AIN5) at (41.045, 24.065) instead of pad 12 (AIN4) at
    (43.585, 24.065), one 2.54 mm pitch away. That shorted the two analog
    inputs and left pad 12's own B.Cu stub orphaned, which showed up as a
    shorting_items error, a solder_mask_bridge error and an
    unconnected_items error. The short is present in the committed gerbers,
    so the boards described by hardware/gerbers read the same voltage on
    AIN4 and AIN5. Replace the bad diagonal with a horizontal run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
    [fan_controller.kicad_pcb]
2026-10-23 hw: regenerate gerbers from the fixed PCB
    Re-export fan_controller-*.gtl/.gbl/.gto/.gbo/.gts/.gbp/.gm1/.drl,
    the drill map and the job file from fan_controller.kicad_pcb
    (28a0d07) via kicad-cli, and rebuild fan_controller_gerbers.zip.
    The previous gerbers (92f6105) predate that fix and carry the AIN4/
    AIN5 short as a track from (38.98, 22.0) to (41.045, 24.065) on
    F.Cu; the new F_Cu.gtl flashes AIN4 at J2 pad 12 (43.585, 24.065)
    instead. v0.0.1's fan_controller_gerbers.zip release asset has the
    same short baked in.
    F_Silkscreen.gto and B_Silkscreen.gbo also lost ~400 D03 flashes
    each. These were %TO.C,<ref>*% component-attribute flashes using
    the pad's own roundrect aperture, placed exactl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
    [fan_controller-B_Cu.gbl, fan_controller-B_Mask.gbs, fan_controller-B_Paste.gbp, fan_controller-B_Silkscreen.gbo, fan_controller-F_Cu.gtl, fan_controller-F_Mask.gts, fan_controller-F_Paste.gtp, fan_controller-F_Silkscreen.gto]
2026-10-23 DC mode support
    [bom.csv, fan_controller.kicad_pcb, fan_controller.kicad_sch, fan_controller.step]
2026-10-23 hw: fix schematic connectivity errors and sync PCB to new nets
    Convert local labels to global labels so net names stop getting a
    sheet-path prefix (/+12V vs +12V) on PCB sync. Add missing junction
    markers at four T-tapped gate-drive/tach points that touch a crossing
    wire's body but weren't bonded to it, and missing GND symbols on the
    channel-1 gate-bias resistor, channel-3 flyback diode, and the AIN
    clamp/filter network. Resolve a duplicate #PWR101 annotation. Sync the
    PCB from the schematic now that nets match cleanly (ERC 57->17
    violations, 41->13 errors).
    [fan_controller.kicad_pcb, fan_controller.kicad_sch]
2026-10-24 hw: clean up motor-switch duplicate footprints and dead-net shorts
    Remove stray duplicate Q17/Q18/Q19/Q20 (Q_en) and R44-R47 (R_dcen)
    footprints left over from PCB sync, and delete the leftover copper on
    the resulting dead Net-(Qn-...) nets that was shorting the live
    Q_inv/Q_en cascode nets (Net-(Q13-S), Net-(Q16-S), Net-(Q17-D)).
    Reconnect J2 pin1/pin2 to GND in the schematic (found floating, no
    wire or power symbol). Align the 4 board-perimeter bolt holes into a
    clean rectangle (one corner was 0.1mm off). DRC shorting_items for
    this feature's nets cleared; remaining DRC errors are pre-existing and
    out of scope.
    [fan_controller.kicad_pcb, fan_controller.kicad_sch]
2026-10-24 hw: regenerate BOM from schematic, actualize docs to current sch/pcb
    bom.csv was hand-curated and stale (missing all motor-switch parts:
    Q_inv/Q_en, Q_hs, Q_pnp, flyback diodes, JP jumpers). Regenerate it
    from the schematic (grouped by value/footprint) and merge the old
    MPN/notes columns back in.
    Bring README.md and hardware/datasheets/README.md in line with the
    current schematic/PCB: BOM summary table, board outline size
    (75x60 -> actual 81x78 mm), fresh ERC/DRC counts, datasheet links for
    the new motor-switch parts (AO3401A, MMBT3906, SS34) with the removed
    USB ESD part dropped, and removal of the TODO item the DC-mode feature
    now closes.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
    [bom.csv]
2026-10-24 hw: fix missing 3D models for new motor-switch footprints
    Q17-20, R44-47, D8-11 and JP1-4 pointed at ${KICAD10_3DMODEL_DIR}
    (the generic library path) instead of the project's local
    ${KIPRJMOD}/3dmodels/ copies, so they rendered as empty/missing.
    Copy the missing D_SMA and R_1206_3216Metric models in from the
    system KiCad library, repoint all 16 footprints at the local copies,
    and regenerate hardware/pcb_3d.png.
    [fan_controller.kicad_pcb]
2026-10-24 docs: redraw block overview as a native Mermaid diagram
    Replace the ASCII-art block overview with a color-coded Mermaid
    flowchart (renders natively on GitHub) and add the DC-mode
    motor-switch path (Q_inv/Q_en/Q_pnp/Q_hs), which the old diagram
    never showed.
2026-10-24 PCB small corrections and rerouting
    [fan_controller.kicad_pcb]
2026-10-25 Board rework
    [fan_controller.kicad_pcb, fan_controller.kicad_sch]
2026-10-30 Replaced bipolar transitor with AO3401A
    [fan_controller.kicad_pcb, fan_controller.kicad_sch]
2026-10-30 hw: regenerate gerbers from current PCB
    Re-export all gerber layers, drill file, drill map, job file and
    fan_controller_gerbers.zip from fan_controller.kicad_pcb after the
    Q_pnp transistor swap and full reroute.
    [fan_controller-B_Cu.gbl, fan_controller-B_Mask.gbs, fan_controller-B_Paste.gbp, fan_controller-B_Silkscreen.gbo, fan_controller-Edge_Cuts.gm1, fan_controller-F_Cu.gtl, fan_controller-F_Mask.gts, fan_controller-F_Paste.gtp]
2026-10-30 ci: add firmware build/test, gerber export, and release workflows
    Gate tagged releases on firmware CI and gerber export both passing
    before attaching fanny.elf/.bin and the gerbers zip. Also renames the
    firmware build target from fanctl to fanny to match the project name.
2026-10-30 ci: run gerbers container as root to fix checkout EACCES
    kicad/kicad's default non-root user has no write access to the
    runner-owned /__w/_temp mount, so actions/checkout's save-state
    file write failed with EACCES.
2026-10-30 ci: rename gerbers zip to fanny-gerbers.zip
2026-10-30 ci: scope gerbers trigger to the PCB file only
    Was matching every file under hardware/kicad/, so schematic-only
    edits, library tables, and backups triggered a gerber export too.
2026-10-30 ci: install zip before packing gerbers
    kicad/kicad image has no zip binary, step failed with exit 127.
2026-10-31 BOM list sync and pcb corrections
    [bom.csv, fan_controller.kicad_pcb, fan_controller.kicad_sch]
2026-10-31 fix: quote BOM note containing a comma
    The MF-MSMF110/16-2 note had an unquoted comma, giving that row 10
    fields instead of 9 and breaking CSV parsing.
    [bom.csv]
2026-10-31 bom: swap 5 parts for cheaper in-stock equivalents
    SS34 -> SMC Diode Solutions SS34AF, BSS138 -> MCC BSS138-TP, 1uF 0603
    -> Taiyo Yuden EMK107B7105KA-T, 10uF 1206 -> Murata GRM31CR71E106KA12K,
    1k resistors -> Vishay Dale CRCW06031K00FKEA. Same specs/package,
    verified live against DigiKey. Cuts per-board part cost ~19% ($28.58
    to $23.19).
    [bom.csv]
2026-11-09 feat: rework fan DC-mode schematic (S2, all 4 channels) and sync PCB
    Per-channel cascode (Q_inv + Q_en series, PNP gate lift, P-FET
    high-side) replaces the broken pass-gate DCEN topology on all four
    fan channels. Fixes the swapped MCU pin columns, the duplicate net
    labels that shorted per-channel fuses and PWM outputs together, and
    the R_gpd time constant (100k to 2.2k). ERC clean, 0 errors/warnings.
    PCB synced from the schematic and autorouted: 774 tracks, 65 vias,
    DRC clean. Added +12V_F1-F4 to the Power netclass alongside the other
    fan rails (0.3mm/0.6mm via), matching the current they carry; the
    rerouted segments on those four nets still need their width bumped to
    match, tracked separat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
    [fan_controller.kicad_pcb, fan_controller.kicad_sch]
2026-11-10 Fix wrong Molex 12V line
    [fan_controller-B_Cu.gbl, fan_controller-B_Mask.gbs, fan_controller-B_Paste.gbp, fan_controller-B_Silkscreen.gbo, fan_controller-Edge_Cuts.gm1, fan_controller-F_Cu.gtl, fan_controller-F_Mask.gts, fan_controller-F_Paste.gtp]
2026-11-10 bom: fix Q-transistor reference mismatch against PCB
    AO3401A/BSS138 reference groups in bom.csv no longer matched the
    actual Value field on the board for most of Q1-Q20 (refs were
    reshuffled during schematic rework, BOM wasn't). Totals were right
    (8 AO3401A, 12 BSS138) but several refs pointed at the wrong part,
    which matters for assembly cross-checks even if ordering quantity
    was unaffected. Merged into two correct reference lists derived from
    the current fan_controller.kicad_pcb.
    [bom.csv]
2026-11-10 firmware: flash status LED on host activity instead of heartbeat
    PC13 now pulses once per completed line from the host (protocol.c
    sets a pending flag on line completion, main.c clears it and drives
    the LED) instead of free-running at 1 Hz / 4 Hz. Useful as a visual
    comms indicator while bringing up a board with no driver parts
    populated yet.
2026-11-10 fix: capture millis() after draining USB input, not before
    main()'s loop read `now` at the top, then processed any buffered host
    command. If that command called safety_host_seen() (stamping
    host_seen_ms with its own later millis() read), the loop's stale
    `now` could end up smaller than host_seen_ms. safety_update()'s
    `now - host_seen_ms` is unsigned, so that went negative and wrapped
    to roughly 4 billion, well past the 10 s failsafe threshold, tripping
    an instant, spurious failsafe and forcing every fan to 100% right
    after a normal command, independent of real elapsed time.
    Moved the millis() read to after the incoming-byte loop so it can
    never be older than a host_seen_ms stamped during th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
    [main.c]
2026-11-10 fix: make millis() interval checks rollover-safe
    millis() now counts 0..INT32_MAX and wraps to 0 about every 24.8 days.
    ms_since(prev, now) in board.h returns the elapsed ticks, counting
    INT32_MAX - prev + now + 1 when the counter wrapped in between.
    The safety host timeout and stall check, the tach window and both USB
    timeouts now go through ms_since(). The status LED compared absolute
    deadlines (now + 50 against now >= off_at), which cut the pulse short
    near a rollover. It now stores the start time and checks the elapsed
    time instead.
    ms_since() reads any now < prev as a rollover, so callers must take
    prev from an earlier millis() read than now. main() keeps that order
    by reading now aft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
    [board.h, main.c, safety.c, tach.c]
2026-11-11 Added example for NTC termal analog resistor
2026-11-11 hardware: add AIN bias resistors, resync schematic and BOM
    Each AIN channel's 3V3A-to-SIG divider had no pull-up: the ratiometric
    NTC divider README documents never existed on the schematic. Added
    R39-R42 (33k, matching the NTCM-HP-33K-1% thermistor) from +3V3A to
    each AINn_IN node via global labels, no new wires.
    Schematic annotation and PCB sync shifted several refs; BOM
    regenerated from current schematic state (values, footprints,
    reference lists) instead of patched on top of the stale one.
    [bom.csv, fan_controller.kicad_pcb, fan_controller.kicad_sch]
2026-11-11 fix: move CH1 V12 sense off dead PB0 pin to PA4
    PB0 (ADC1 IN8) didn't track voltage during bench test (stuck ~0.3V
    across 2.788V and 3.3V direct injection, plus USB reset on contact) -
    dead/disconnected channel on the soldered CH1 board. Moved the ADC
    scan to PA4 (IN4), confirmed live with the real divider wired up
    (raw=3431, mv=11095). Also corrected the divider ratio constant for
    the actual R1/R2 values (10k/3.3k, was coded for 47k/10k) and exposed
    raw ADC counts in the v12 status line for debugging. Updated BOM and
    schematic (R1/R2 values, no_connect) to match.
    [bom.csv, fan_controller.kicad_pcb, fan_controller.kicad_sch]
2026-11-11 feat: standalone NTC auto mode, bump host failsafe to 20s
    Add `auto on|off`: the board drives every channel's duty from its own
    AIN thermistor via a compile-time temp->duty curve (mirrors
    host/fancontrol.conf.example's defaults), once a second, with no host
    needed. While on, the host-silence failsafe is fully bypassed rather
    than just deferred - an out-of-range AIN reading (sensor open/shorted)
    forces that channel to 100% instead of trusting the curve.
    Also bumps SAFETY_HOST_TIMEOUT_MS from 10s to 20s, since a host-driven
    daemon polling at a couple-second interval was cutting it close.
    [autocurve.c, autocurve.h, fancontrold.py, fanctl.py, main.c, protocol.c, safety.c, safety.h]
2026-11-11 ci: build firmware and gerbers inline in release workflow
    Drop the ci/gerbers sub-job + artifact download/upload indirection.
    Release job now compiles firmware and exports gerbers directly.
2026-11-11 Revert "ci: build firmware and gerbers inline in release workflow"
    This reverts commit 0593b5e46420ab6f09fae73273e9a0d2c8979f38.
2026-11-12 feat(fw): count tach in hardware timers, add PWM floor and start kick
    Count fan 1-3 tach with TIM1/TIM2/TIM3 in external clock mode (PA9, PA15,
    PB5), so short mid-period glitches no longer inflate RPM. Fan 4 stays on
    EXTI15 with a pin-level check. The 1 s window runs on the DWT cycle
    counter. The tachcap debug capture is removed.
    Map duty 1-100 % onto 10-100 % and run a stopped fan at 30 % for 2 s
    before a low duty, since the NF-P12 won't start below 10 %. Raise the
    host-silence failsafe to 1 hour.
    [board.h, fan.c, fan.h, fancontrold.py, fanctl.py, main.c, pwm.c, safety.h]
2026-11-12 hardware: route fan 1-3 tach to timer pins PA9, PA15, PB5
    Move FAN1-3_TACH_IN off PB12-PB14 so TIM1-TIM3 can count the edges in
    hardware. PB12-PB14 are now no-connect; fan 4 stays on PB15. Sync the PCB
    and record the routing-tool fab limits in the project file.
    [fan_controller.kicad_pcb, fan_controller.kicad_sch]
2026-11-12 docs: describe timer tach counting and low-duty limits
    README pin map and limits cover the TIM1-TIM3 tach counters, fan 4 on
    EXTI15, JTAG off for PA15, and the 10 % duty floor.
2026-11-12 fix: restore 20 s host-loss failsafe
    The 1 hour timeout was a bench convenience. Without auto mode, fans go
    back to 100 % after 20 s with no host command again; auto mode still
    disables the check.
    [fancontrold.py, fanctl.py, safety.h]
2026-11-13 feat(fw): replace NTC Beta-equation math with per-channel lookup tables
    Blue Pill's Cortex-M3 has no FPU, so logf() for the autocurve NTC
    conversion ran in software. Swap it for a mV->degC table per AIN
    channel, integer-only interpolation, matching the 10k/B3950 probe and
    its matching 10k pullup on each channel.
    Add host-side unit tests (test_autocurve.c) covering table/curve
    clamping, interpolation, invalid-sensor failsafe, per-channel
    independence, and the auto on/off toggle. Wired into `make test`.
    [autocurve.c, ntc_calib.h, test_autocurve.c]
2026-11-13 docs: update NTC guidance from 33k example to the 10k probe in use
    README and the datasheets index pointed at a 33 kΩ NTC as the worked
    example even though the board's pull-ups and firmware default are
    10 kΩ. Rename the response-curve note to the 10k/B3950 part actually
    in use (the Skip0ner 1X4L module's bundled probe) and make it the
    documented default instead of an alternate example.
2026-11-13 hardware: fix PCB DRC errors, rework AIN3/AIN4/GND routing
    Shorts and solder-mask bridges came from AIN3/AIN4 cutting across
    unrelated fan-header pads near J4/J5/J6/J11/F2; GND track sat 0.14mm
    from J6's mounting hole; FAN4_TACH_IN had a routing gap. Rerouted the
    affected nets individually, verified against kicad-cli DRC.
    MH1/MH2 mounting-hole footprints held stub bodies missing the
    library's courtyard/fab graphics and used a 3mm pad on *.Mask only
    instead of the library's annular-free 2mm pad on *.Cu+*.Mask, so DRC
    flagged them as not matching MountingHole:MountingHole_2mm. Rewrote
    both to match the library copy exactly.
    [fan_controller.kicad_pcb, fan_controller.kicad_sch]
2026-11-13 pcb_3d render update
2026-11-14 feat(fw): print per-channel NTC temperature in get command
    get now reports ntc <ch> temp=<degC>, or temp=NA when the AIN
    reading is out of range (sensor open/shorted). Exposes the existing
    autocurve lookup via a new autocurve_ntc_temp_c() wrapper, for
    host-side visibility into the temp curve during verification.
    [autocurve.c, autocurve.h, protocol.c]
2026-11-14 hardware: reverse-polarity block diode and fault LED
    D1 was an SMBJ13A TVS in series between F1 and the +12V bus, cathode
    toward F1, so it blocked normal power. Replaced it with an SS54
    Schottky, anode on the F1 side. In ngspice the bus drops 0.36V at
    1.9A fan load and stays within 0.12V of 0V with -12V or -24V on the
    input. V12_SENSE stays above -0.03V.
    Added a wrong-polarity indicator from GND to VIN_12V: R47 4.7k (1206),
    red LED1, and D10 1N4148WT. R48 10k across LED1 holds its reverse
    voltage near 0V during normal operation. On a reversed supply LED1
    draws 1.9mA at 12V and 4.4mA at 24V.
    Synced the PCB and re-rendered pcb_3d.png.
    [fan_controller.kicad_pcb, fan_controller.kicad_sch]
2026-11-14 fix(test): stub NTC temp in protocol test, keep autocurve off AIN1
    eea2db0 made cmd_get call autocurve_ntc_temp_c(), but test_protocol
    links only protocol.c, so the CI test step failed with an undefined
    reference. Add a fake that returns 25, -7 and invalid, and check the
    ntc lines it produces in get.
    test_autocurve drove channel 0, whose AIN1 table is being recalibrated
    for a different probe. Run the same checks with the same expected
    values on channels 1 and 2, which keep the nominal 10k/B3950 table.
    [test_autocurve.c, test_protocol.c]
2026-11-14 fix(fw): correct NTC tables to exact 10k/B3950 reference
    Channels 1-4 shared a model-estimated 10k/B3950 curve; channel 1 also
    carried its own probe-specific scaling. Replace all four with exact
    resistance points from Focusensing's 10k thermistor reference chart,
    now that channel 1 uses the same nominal 10k part as 2-4.
    [ntc_calib.h, test_autocurve.c]
